BChris98/Advanced-PCB-Project/README.md

# Advanced-PCB-Project
Creating a PCB project for a led driver and an arduino
