BChris98/Advanced-PCB-Project/Pre-Rapport.docx

# Pré-Rapport : Advanced PCB Design

## Introduction :

Notre projet consiste à créer un shield Arduino comprenant :

- Une source de tension d’entrée comprise entre 19-24V
- Une alimentation stabilisée pour l’Arduino Uno
- Un circuit de contrôle de charge d’une batterie de 12V
- Une alimentation 35V pour les LED
- Une alimentation +/- 9V pour les Aop
- Une consigne pour le driver LED
- Driver LED (Bureau d’étude Electronique de puissance)

Pour cela, nous utiliserons différents ICs détaillés ci-dessous.

Schéma Bloc :

Voici le schéma bloc que nous avons décidé de créer pour le shield :

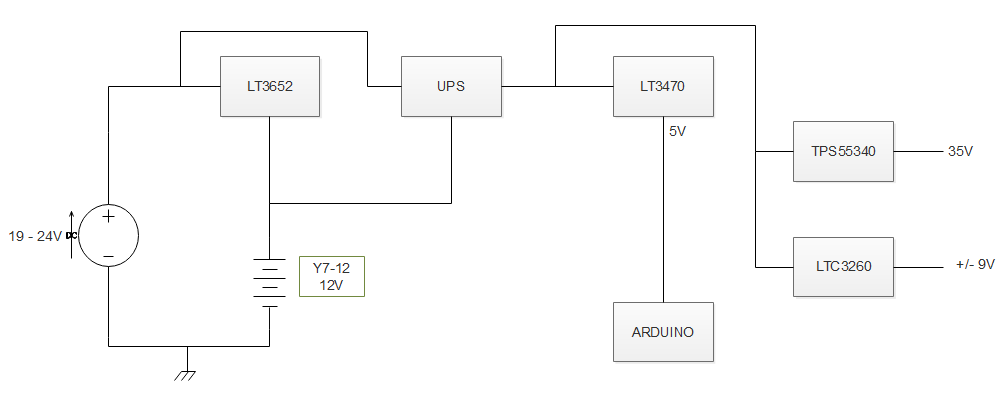
[picture p1: figure]

## LT3470 :

Le LT3470 est un buck converter capable de rabaisser une tension donnée, de 1.25V à 16V et de fournir un courant maximum de 200mA.

Il ne servira qu’à alimenter notre Arduino, donc nous n’avons pas besoin d’un buck converter capable de délivrer une grosse puissance.

Voici le schéma de ce buck converter :

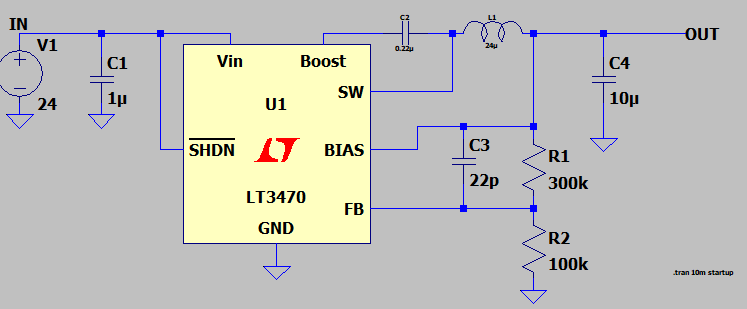
[picture p2: figure]

Nous allons maintenant décrire toute les entrées de l’IC, ainsi que chaque composant externe à cet IC.

Entrées :

- SHDN : C’est la pin utilisée pour shutdown l’IC. Si on n’utilise pas cet option, il faut relier la pin à V_(IN) .
- NC : Non-Connected pin.
- V_(IN) : Pin d’entrée de l’IC.
- GND : Ground de l’IC.
- SW: C’est l’output du switch interne.
- BOOST: Cette pin est utilisée pour booster via le NPN interne.
- BIAS: Cette pin est connectée à la diode Schottky interne ainsi qu’au régulateur interne. Si V_(OUT) >2V , il faut la connecter à V_(OUT) , sinon à V_(IN) .
- FB: C’est la feedback pin du régulateur interne.

Composants :

- Capacité V_(IN)

Une capacité d’entrée est conseillée pour la stabilité. Une entre 1µF à 2.2µF satisfait cette requête. Nous choisissons donc une de 1µF.

- Inductance :

L’inductance se calcule via cette formule donnée :

L_(MIN) = (V_(IN(MAX)) *t_(ON-TIME(MIN)))/(I_(MAX))

Où :

    - V_(IN(MAX)) =24V
    - t_(ON-TIME(MIN)) =150ns
    - I_(MAX) =150mA

L_(MIN) =2,4*10^(-5) H=24µH

- Feedback :

Le feedback est calculé par un diviseur résistif. Ces résistances sont calculées via cette équation :

V_(OUT) = 1.25V*(1 +(R1)/(R2))

(R1)/(R2)=3

Suivant la série E12 des résistances, nous trouvons :

  - R1 = 300k Ω
  - R2 = 100k Ω
- BOOST Pin :

La capacité et la diode Schottky interne sont utilisées pour générer un boost. Dans la plupart des cas, une capacité de 0.22µF suffira.

- Capacité BIAS :

Le ripple de sortie peut être réduit par l’ajout de capacité de découplage de 22pF entre BIAS et le FB.

- Capacité V_(OUT) :

La capacité de sortie filtre les ondulations non voulues du courant de l’inductance. Pour garder ces ondulations faibles, il nous faut une capacité de :

C_(OUT) > 50*L*((I_(LIM))/(V_(OUT)))^2

Où :

    - L = 0.24µF
    - I_(LIM) = 325mA
    - V_(OUT) =5V

C_(OUT) >5,88µF

Nous pouvons donc prendre une capacité de 10µF.

Simulation :

Voici donc ce que donne la simulation avec nos valeurs :

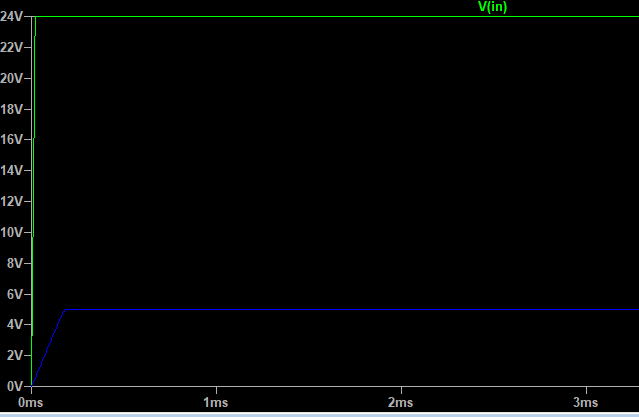
[picture p3: figure]

Nous pouvons voir que pour une entrée de 24V, nous avons bien une sortie de 5V.

## Uninterruptible Power Supply (UPS):

### LT3652 :

Cet IC permet de gérer la charge de la batterie au plomb, délivrant le courant de charge nominal de 1.7A à la tension de 13V, et gérant de façon appropriée le début et la fin de charge de batterie au plomb.

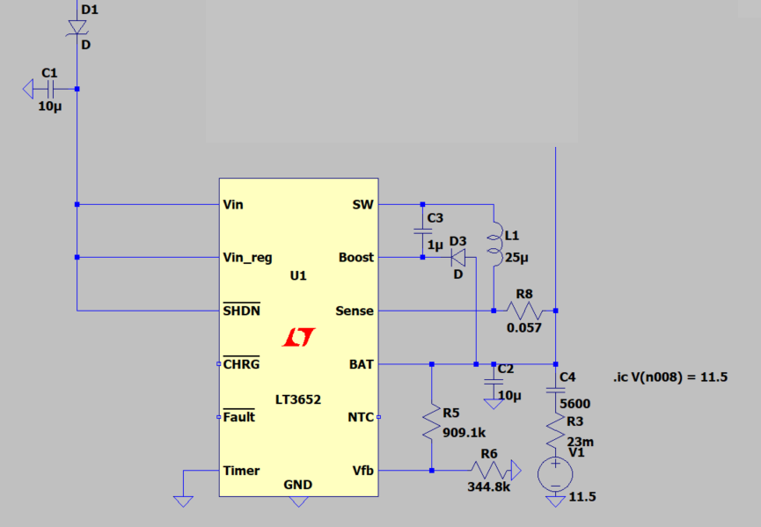
[picture p4: figure]

Le choix de l’IC s’est fait sur base des caractéristiques de charge de la batterie (tension de charge, courant de charge, type de batterie) ; la décision finale de sélectionner le LT3652 a été influencée par l’existence d’un modèle LTSpice du chargeur, rendant la simulation plus facile.

L’ensemble C4 R3 V1 est une modélisation du comportement de la batterie au plomb. R3 représente la résistance interne de la batterie, V1 représente la valeur de tension à vide (charge à 0%) de la batterie, et C4 est calculé à partir de la valeur de la capacité de la batterie, selon l’équation :

C=(Q*3600)/(∆V) [F]

Où ΔV est la différence entre la tension à 0% et celle à 100% de charge, et Q la charge (en Ah) de la batterie. [^1] Ce modèle a probablement une précision et un réalisme limité, mais suffit dans le cadre de notre simulation.

Le reste des composants sur ce schéma sont les composants de réglages du chargeur, dimensionnés selon les recommandations de la datasheet, comme décrit plus bas. Remarquons les condensateurs C1 et C2 qui servent de capacité de découplage.

Pins layout

- V_(IN) : Pin d’entrée/d’alimentation de l’IC (entre 4.95 et 32 V, et minimum 3.3V de plus que la tension de charge de la batterie => 15.3 V).
- V_(IN_REG) : Pin de régulation du courant de charge en fonction de la tension d’entrée. Puisque cette fonctionnalité n’est pas utilisée, la pin est connectée à Vin.
- SHDN : Désactive toutes les fonctions de charge si ShutDown est activé. Cette fonction n’est pas utilisée, la pin doit donc être connectée à Vin.
- CHRG : Indique le status de la sortie du chargeur ( CHRG est à 0 si la charge est en cours (le courant de charge est > Imax/10)). Cette pin peut être laissée flottante.
- FAULT : Indique les conditions de fautes durant un cycle de charge de la batterie. Cette pin peut également être laissée flottante.
- Timer : Pin de programmation de durée de charge, utilisée si on souhaite programmer une fin de charge après un certain délais (de plus, une faute apparait sur la pin précédente si la fin de charge n’est pas atteinte à la fin de ce délais). Cette fonction n’est pas utilisée non plus, la pin doit donc être connectée à la masse.
- V_(FB) : FeedBack de tension de batterie. La fonction de charge du LT3652 cherche à atteindre une tension de 3.3V sur cette pin ; le diviseur résistif doit donc être dimensionné à cet effet (pour qu’une tension de batterie pleine corresponde à 3.3V sur la pin).
- NTC : Pin de contrôle de la température, à laquelle connecter une thermistance de 10kOhms (à placer dans la batterie). Cette pin peut être laissée flottante.
- BAT : Pin de sortie du chargeur (sur laquelle il faut placer une capacité de découplage de 10µF). Lorsque le cycle de charge est terminé, cette pin délivre un courant < 1µA pour minimiser la décharge de la batterie.
- SENSE : Pin de détection de courant de charge, également utilisée pour fixer le courant de charge maximum.
- BOOST : Rail d’alimentation des interrupteurs, monté en bootstrap (avec un condensateur 1µF).
- SW : Pin d’output de l’interrupteur de sortie, qui court-circuite SW avec la pin Vin. Cette pin est bootstrappé à la pin BOOST.
- GND : Masse de l’IC.

Dimensionnement

Dimensionnons le pont résistif sur la pin V_(fb) . Les équations suivantes sont fournies dans la datasheet :

R1= (V_(BAT) (flt).2,5.10^5)/(3,3)

R2=(R1.2,5.10^5)/(R1-(2,5.10^5 ))

En sachant que V_(bat) (flt) = 13.65 V, on a R1 = 1034090.090 et R2 = 329710.527, avec un rapport R1/R2 de 3.1363 (d’autres résistances avec ce rapport et de l’ordre de grandeur des 100k peuvent être utilisées). Les valeurs de résistance présentes dans la simulation sont celles permettant d’obtenir une tension V_(bat) (flt) de 12V, qui est la tension nominale de la batterie et non sa tension de charge.

La tension sur la résistance placée sur la pin SENSE permet de régler le courant de charge moyen. Une tension de 100 mV correspond au courant de charge maximal (qui doit être <2A). L’équation permettant de trouver la valeur de résistance est donc simplement :

R_(SENSE) =0.1/(I_(CHG(MAX))) [Ω]=(0.1 V)/(1.75 A)=0.057Ω

La valeur d’inductance permet de régler l’amplitude d’oscillation du courant de charge. La datasheet recommande une amplitude relative d’oscillation (amplitude d’oscillation/offset DC = Ichg(max)) comprise entre 25 et 35%. La formule fournie permettant de trouver la valeur d’inductance est :

L=10*(R_(SENSE))/((ΔI_L)/(I_(CHG(MAX))))*V_(BAT(FLT)) *[1-(V_(BAT(FLT)))/(V_(IN(MAX)))](µH)

Ce qui donne, pour une amplitude relative d’oscillation de 25% et un Vin(max) de 24V, une valeur d’inductance de 13.42 µH. Il a cependant été observé à la simulation qu’avec une telle valeur d’inductance, l’amplitude relative était supérieure à 35% ; nous avons donc choisi une inductance de 25 µH, avec laquelle nous obtenons une amplitude de 18%.

Il est également spécifié dans la datasheet que l’inductance doit avoir un courant de saturation supérieur ou égale au courant maximum présent (en peak) dans l’inductance, soit supérieur à 2A.

### Changement de source :

Le circuit de charge a été simulé en même temps que celui de changement de source de tension, permettant la fonction d’UPS, dont voici le schéma :

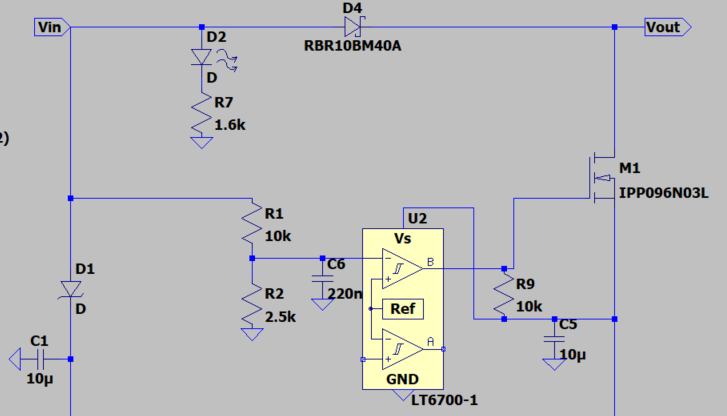
[picture p5: figure]

Le transistor NMOS M1 (à droite sur le schéma) permet de faire basculer la sortie V_(out) sur la batterie (voir schéma global ci-dessous). Sa grille est commandée par un comparateur, qui compare une référence de 400 mV avec la valeur de tension d’entrée divisée par 4.

Il en découle que si V_(in) tombe en dessous de 1.6V, la sortie du comparateur passe à l’état haut au travers de la résistance de pull-up R9, et M1 est passant ; si V_(in) est au-dessus de 1.6V, la sortie du comparateur est à l’état bas (la sortie du comparateur est en open-collector), et M1 est bloqué.

La diode D4 permet d’éviter que la batterie n’alimente le circuit de charge et l’entrée du comparateur (ce qui rebloquerait le transistor M1).

La led D2 servira de repère visuel rapide indiquant la présence d’une alimentation externe.

Les condensateurs C5 et C6 servent également de capacité de découplage.

Dimensionnement

Le transistor M1 a été choisi pour sa faible valeur R_(ds_(on)) , permettant de minimiser les pertes, ainsi que pour son grand courant de drain maximum et sa tension de seuil appropriée.

La diode D4 a été choisie pour son grand courant direct maximum (10A) et sa faible chute de tension directe (0.6V), permettant de plus faible pertes ; ainsi que sa bonne dissipation thermique ; une autre diode respectant ces critères serait tout aussi adaptée (le footprint utilisé n’est pas celui du modèle de diode de la simulation).

La résistance R7 permet de limiter le courant circulant dans la led. Pour une led montée en surface typique, un courant de 25 mA est nécessaire avec une chute de tension de 3V. Ceci veut dire que la résistance doit provoquer une chute de tension de 24-3 = 21V, avec un courant de 25 mA :

21V=R*0.025A=>R=840 Ω

Le pont diviseur en entrée du comparateur a été dimensionné pour avoir un rapport de division de 4, permettant une ouverture plus réactive du transistor M1 (l’entrée du comparateur peut aller jusqu’à 36V, cette valeur n’était donc pas limitante). Ainsi, le transistor M1 s’ouvrira après que la tension d’entrée soit passée sous les 1.6V et non les 400 mV.

### Schéma global

Ceci donne comme schéma global :

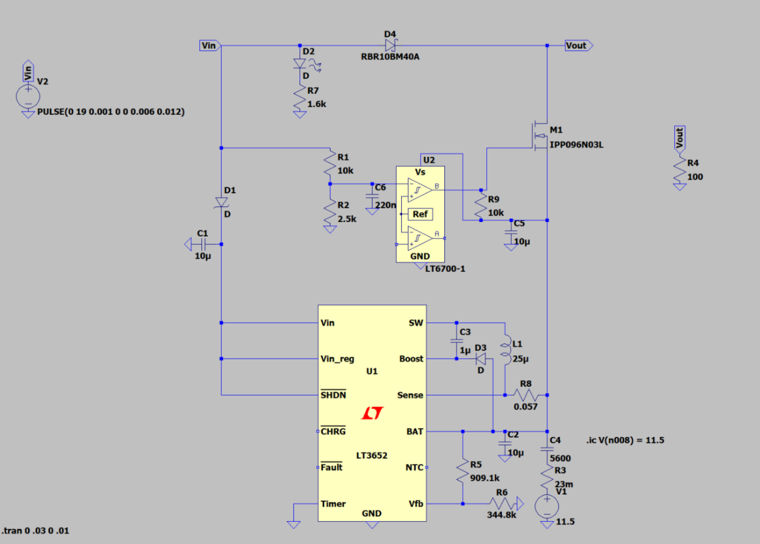
[picture p6: figure]

R4 symbolise une charge placée en aval du circuit.

Simulation

La simulation est réalisée en analyse transitoire, sur une durée de 30 ms. Durant cette période, nous simulons successivement la connexion et déconnexion d’une source de tension externe de 19V, ce qui nous permet d’observer le bon fonctionnement de la fonction « UPS » en même temps que celui de la fonction de charge de la batterie.

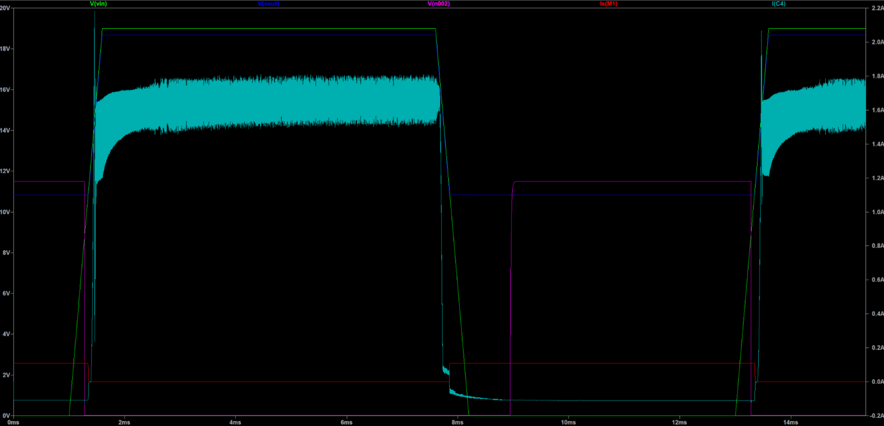
[picture p7: figure]

Tout d’abord, observons que la tension de sortie transitionne effectivement entre la tension de batterie et la tension Vin – 0.6V (chute due à D4), lorsque celle-ci est non nulle (quand on connecte une alimentation externe).

Ensuite, observons qu’un courant ne circule dans le transistor M1 que quand la tension Vin est sous un certain seuil (normalement 1.6V, mais le seuil semble ici se trouver à environ 12V => quand Vds vaut environ 0V). De plus, ce courant vaut bien 12V/100Ohms = 120 mA, comme attendu (diminuer la valeur de résistance de la charge fait augmenter le courant comme attendu également).

Enfin, observons que le courant dans la batterie (IC4, en bleu clair) devient négatif (à hauteur de -Is) lorsque M1 est passant ; ceci finit de démontrer que l’UPS fonctionne comme attendu. Le transistor est passant, la batterie se décharge et la tension de sortie = la tension de batterie, lorsque l’on retire l’alimentation externe. De plus, la transition se fait à une vitesse satisfaisante (de l’ordre de 0.1 ms).

En ce qui concerne la charge de la batterie (qui a lieu quand la source externe est connectée), le courant moyen varie entre 1.65 et 1.7 A, selon l’instant de la simulation sur lequel on zoome. Les pointes de courant montent quant à elles jusqu’à 1.8 A. Nous sommes donc suffisamment proche des 1.75 A désirés.

L’amplitude de l’oscillation est en moyenne de 1.8-1.48 = 0.32 A, soit 0.32 / 1.75 = 18.2 % de la valeur de courant désiré. Cette amplitude est donc légèrement inférieure aux 25% mentionnés plus tôt, ce qui semble cohérent puisque la valeur d’inductance utilisée pour la simulation est plus grande que la valeur calculée ; avec la valeur d’inductance de 13.42 µH déterminée précédemment, l’amplitude relative était de 41 %.

Enfin, nous avons constaté la présence d’un pic de courant au début de la charge de la batterie, atteignant les 2.2 A. Ce pic de courant est probablement dû au comportement capacitif de la batterie et ne portera pas à conséquence. Le pic est suivi d’une ondulation, jusqu’à ce que le circuit intégré stabilise le courant de charge moyen (ce qui se produit en 0.16 ms).

En conclusion, la fonction UPS et la charge de la batterie se déroule sans problème, dans notre simulation.

## Boost converter :

Afin que le driver de LED puisse délivrer un courant suffisant dans plusieurs LED branches en série, celui-ci doit être alimenté par une tension relativement grande. C’est à cela que sert le boost en convertissant la tension de l’alimentation 19-24V ou de la batterie 12V en une tension de 35V.

N.B : Malheureusement, la datasheet du circuit intégré choisie étant très pauvre en information, nous avons été amenés à nous documenter sur deux PDF de la marque Texas Instrument afin de dimensionner le circuit.

### Choix de l’IC :

Sachant que notre boost est alimenté par une tension comprise entre 12 et 24V et qu’il doit délivrer une tension de 35V avec un courant maximal de 1A, nous avons toutes les informations nécessaires pour trouver le circuit intégré qui répond aux exigences du projet.

Afin de pouvoir facilement réaliser une simulation sur LTSpice, nous nous sommes tournés vers un IC de la marque Linear Technology. Nous nous sommes alors rapidement tourné vers le LT1171 pour sa large gamme de tension d’entrée 3-60V et son courant de 2,5A.

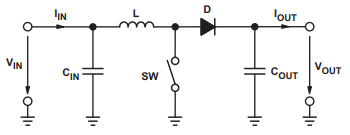
[picture p8: figure]

Mais après la lecture de la datasheet nous nous sommes aperçus que ce courant de 2,5A n’est pas appelé Iout (MAX) mais ILIM, ou “maximum switch current”. On parle donc en fait du courant qui passe par le transistor qui court-circuite l’inductance.

Il nout faut donc calculer nous même le courant de sortie maximal que ce circuit intégré peut délivrer, dans les conditions de notre application.
Ce calcul se fait en plusieurs étapes :

1) Duty-cycle D :

La tension minimale en entrée est utilisée car c’est celle-ci qui provoquera le plus grand courant dans le switch pour augmenter la tension jusque VOUT. Il faut bien sûr prendre en compte le rendement puisque celui-ci est étroitement lié au courant consommé lorsqu’on court-circuite l’inductance au travers du switch. Prendre un rendement minimum de 80% semble effectivement réaliste pour un boost converter.

D= 1- (12*0.8)/35 = 0.725

2) Inductor ripple current

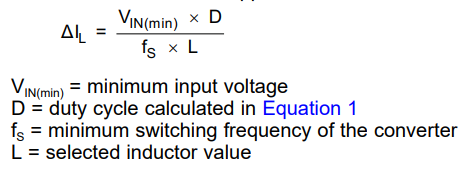
[picture p9: figure]

Le courant d’ondulation de la self varie en fonction de son inductance, mais aussi du duty-cycle et de la fréquence de signal.
La valeur de l’inductance pour faire un boost converter avec le LT117X est donnée par la datasheet et vaut 50uH. Mais selon les articles proposés par RS Components nous avons plutôt opté pour une inductance de 47uH.

ΔIL= (12 * 0,725)/(88*10^3 *47*10^-6) = 1,98 A

3) Maximum output current

ILIM(min) du LT1171 est donné dans la datasheet pour des duty-cycle de 50 et 80%. Afin d’obtenir un résultat le plus correct possible, on peut le calculer pour notre duty-cycle de 72,5% avec la formule ILIM=1,62 * (2 – D). Ce qui donne 2,06A.

IMAX OUT = (2,06- (1,98)/2)*(1-0,725) = 0,294A

On voit tout de suite qu’on est loin du courant maximal de 1A attendu. Il faut donc recommencer le calcul en prenant comme ILIM(min) celui du LT1170 :

ILIM=3,33 * (2 – D)= 4,245 A

Ce qui donne un IMAX OUT de 0.895A. Ce résultat est bien plus proche de notre valeur attendue, mais devrait tout de même être supérieure à 1A. Pour cela nous pouvons augmenter la valeur de l’inductance afin de diminuer le ripple current. La datasheet ne renseignant pas de gamme d’inductance recommandée, déterminons la par la formule proposée dans le PDF de Texas Instrument :

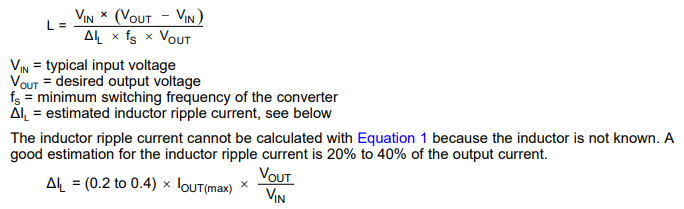
[picture p10: figure]

Ce qui nous donne, en utilisant les valeurs de ΔIL avec des facteurs de 0.2 et 0.4, et pour une Fs type de 100kHz, une gamme d’inductance entre 67 et 135uH.

Recalculons donc le ripple current et le maximum output current avec une inductance de 100uH :

ΔIL= (12 * 0,725)/(88*10^3 *100*10^-6) = 0,989 A

IMAX OUT = (4,245- (0,989)/2)*(1-0,725) = 1,031A

On obtient donc finalement, dans le pire des cas, un courant de sortie maximum suffisant.

On peut donc maintenant réutiliser cette dernière formule afin de calculer le véritable maximum switch current de notre application en ramplacant IMAX OUT par IOUT(max), soit le courant maximal de notre application :

Dans notre cas, on peut dire que IMAX OUT = IOUT(max). Ce qui fait que notre maximum switch current vaut en fait notre valeur minimal de limite du switch current ILIM(min), soit 4,245A.

Selon Texas Instrument, ce ISW(max) de 4,245A est le pic de courant que doivent pouvoir supporter le switch, mais aussi l’inductance et la diode externe.

### Choix de l’inductance :

La capacité de l’inductance a déjà été déterminée dans le choix du circuit intégré et vaut 100uH. Pour ce qui est de son courant, elle doit supporter des courants jusque ISW(max), soit 4,245A. Celui-ci étant en fait la somme du courant moyen dans la self plus la moitié de l’amplitude peak-to-peak du courant d’oscillation.

Nous avons donc opté pour une inductance de 100uH avec un Irms de 5,3A (SRP1770TA-101M).

### Choix de la diode :

Afin de réduire les partes au travers celle-ci, il est nécessaire d’utiliser une diode schottky pour leur faible chute de tension. Leur courant nominal doit être égal ou supérieur au courant de sortie maximum de notre convertisseur, soit 1A.

Les diodes schottky ayant des pics de courant nominaux très élevé, ceux de notre circuit ne poseront pas de problème.

Il faut cependant tout de même s’assurer que la diode peut dissiper sa chaleur :

La diode 1N5819 nous semble parfaitement correspondre au besoins de notre application grâce à son courant nominal IF=1A, sa tension directe VF=0.45V et sa dissipation de 0,45W sous 1A continu (illustrée ci-dessous).

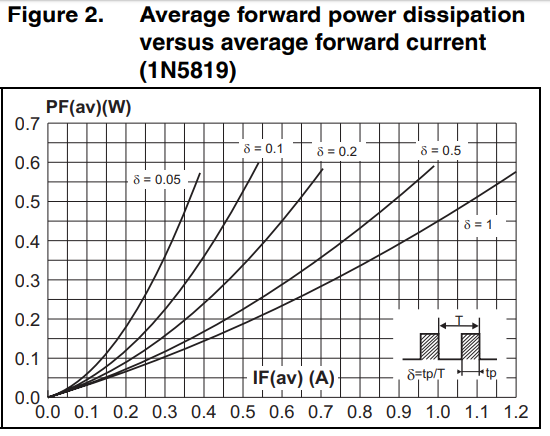
[picture p11: figure]

### Choix du pont diviseur :

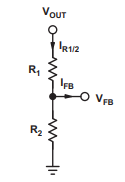
[picture p12: figure]

La tension de référence VFB et le courant de feedback sont donnés par la datasheet, et valent respectivement 1,244V et 350nA.

Il est conseillé par Texas Instrument d’avoir un courant IR1/2 au moins 100 fois plus grand que IFB, afin d’avoir au maximum 1% d’imprécision du la mesure de la tension VFB. Au-delà de 100 fois la précision continue d’augmenter, au dépit des pertes dans les résistances qui augmentent.

À partir de ces valeurs, on peut aisément calculer les valeurs de R1 et R2 comme suit :

Ce qui donne une une résitance R2 de 35,542 kOhm. Ayant pour cette valeur des pertes de l’ordre de 30uW à ses bornes, nous pouvons totalement choisir une résistance plus faible. Nous avons donc choisi une résistance classique de 10k à laquelle correspond une valeur théorique pour R1 de 271,35k. Une résistance de 270k ira donc très bien et fournira une tension de feedback de 1,245V avec la résistance de 10k.

### Choix du condensateur d’éntrée :

Texas Instrument nous conseille de respecter la valeur minimale de capacité en entrée indiquée dans la datasheet, ce afin de stabiliser la tension d’alimentation de l’IC malgré les pics de courant qu’il demande. Nous avons donc choisi d’utiliser le même condensateur que dans l’exemple d’application de la datasheet, soit un condensateur electrolytique de 100uF.

Cependant, il est aussi conseillé de choisir un condensateur céramique pour sa faible résistance série équivalente, ce qui lui permet de facilement fournir des hauts pics de courant. Nous hésitons donc à opter pour un condensateur céramique à la place d’un électrolytique…

### Choix du condensateur de sortie :

N’ayant toujours aucune indication dans la datasheet, nous utilisons la formule proposée par TI :

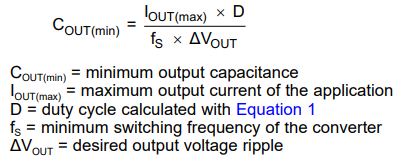
[picture p13: figure]

Cette formule permet de déterminer la capacité qu’il nous faut en fonction de l’oscillation souhaitée sur la tension de sortie. Nous avons choisi une capacité électrolytique de 270uF qui nous donnerait un oscillation de seulement 30mV. Mais la résistance équivalente de cette dernière ajoutant des oscillation, nous ajouterons un condensateur céramique de 100uF.

Une capacité totale de 370uF nous donne une oscillation de 22mV, sans prendre en compte les oscillations qui pourraient être ajoutées par les résistances des condensateurs.

### Simulation :

Schéma du circuit :

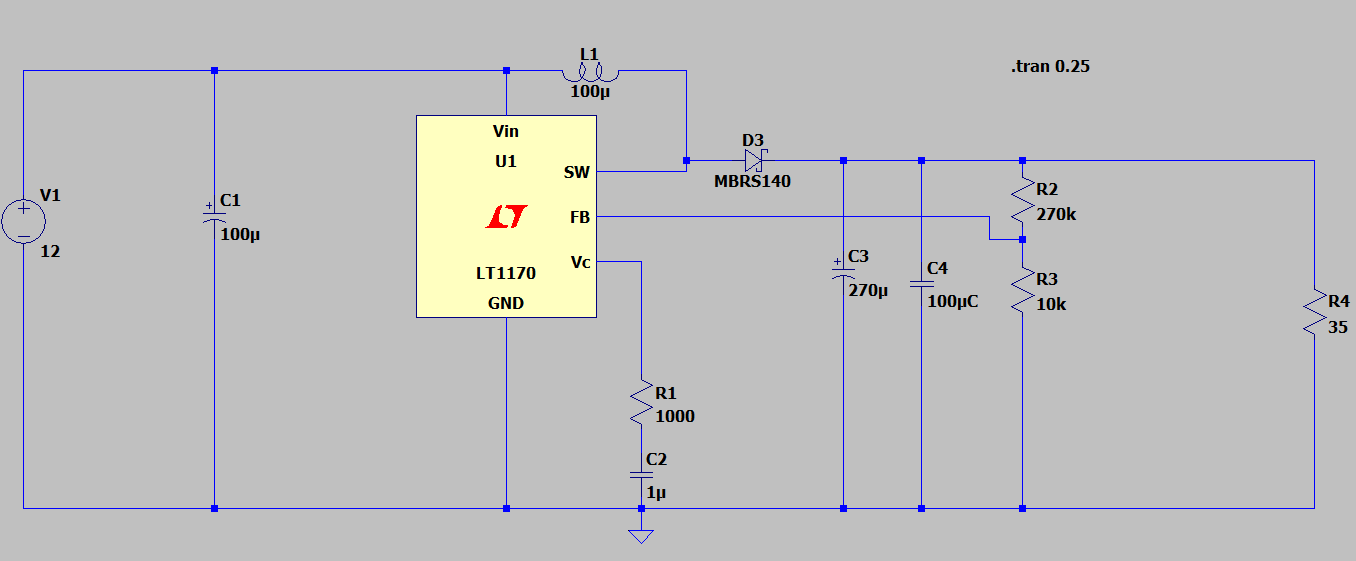
[picture p14: figure]
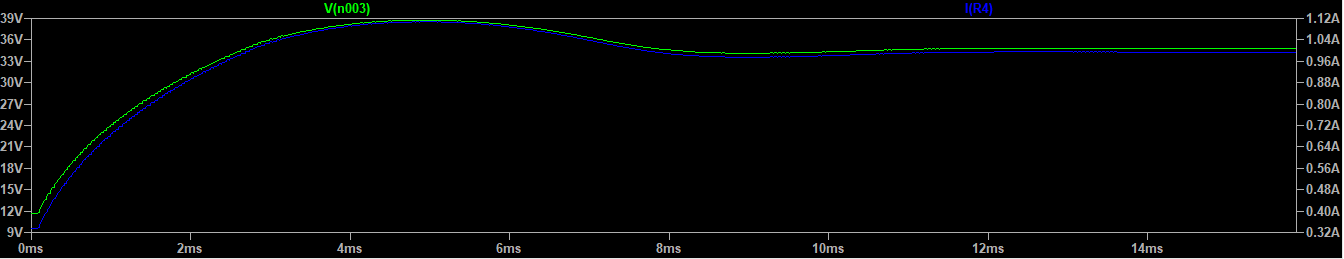
[picture p15: figure]

Sur cette simulation, on peut voir la tension et le courant dans la résistance de 35 Ohm qui grimpent puis se stabilisent après une dizaine de millisecondes à leurs valeurs attendues : 35V et 1A.

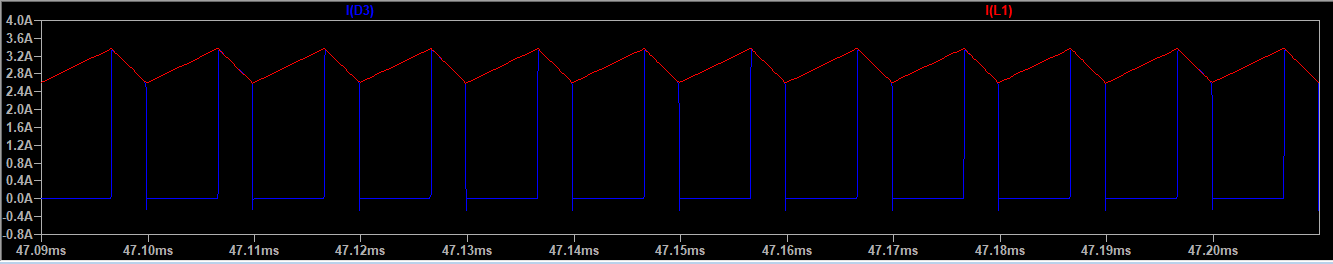
[picture p16: figure]

Ici, on peut visualiser que l’oscillation de courant sur la self correspond à celle précédemment estimée à 0,989A. Cependant, le courant moyen (IOUT/1-D) devrait etre de l’ordre de 3,57A, et pas 3,0A…
Pour la diode, qui conduit lorsque la self se décharge au travers elle, on peut voir qu’elle a effectivement un courant moyen d’environ 1A avec son signal presque rectangulaire de duty-cycle de 28% (1-D) montant jusque 3A.

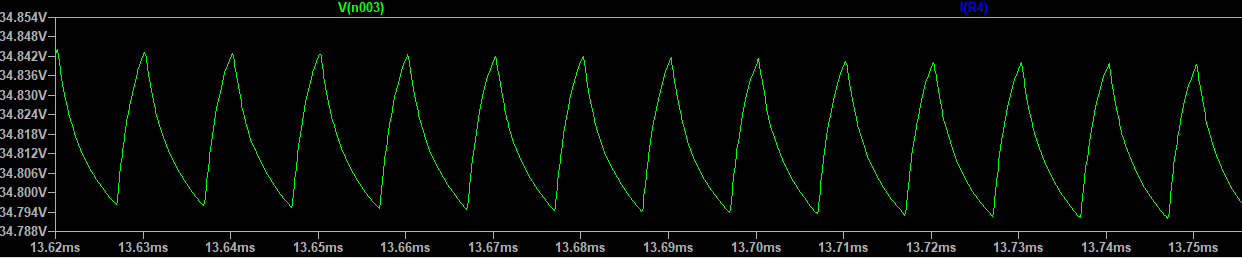
[picture p17: figure]

Cette mesure nous donne une ocillation d’environ 44mV sur la sortie, soit exactement 2 fois la valeur théorique. Pourtant la valeur calculée semble bien être l’amplitude peak-to-peak de l’oscillation…

### Conseils de layout :

Encore une fois, il nous a fallu nous tourner vers un PDF de Texas Instrument de trouver les conseils de layout pour bien concevoir un PCB de boost converter.

Dans l’ordre des priorités, le premier conseil est de placer le condensateur de sortie le plus près possible de la pin du circuit intégré. En effet, le courant étant en pulsations, il pourrait engendrer des pics de tension à cause de l’inductance parasite d’une longue piste. Et ces pics de tensions pouraient s’avérer destructeurs.

Si l’encombrement du gros condensateur de sortie ne permet pas de se mettre assez près, un petit condensateur peut être placé pour lisser la tension le plus près possible de la sortie de l’IC. Le plus gros peut alors être placé un peu plus loin.

Ensuite, l’inductance doit être elle aussi placée le plus près possible du circuit intégré. Mais cette fois, pour réduire au maximum les interférences électromagnétique.

Finalement, tout le reste des composants doivent eux aussi être placés le plus près possible afin de luter contre les inductances et capacités parasites des pistes.

## LTC3260 :

Cet IC permet de nous délivrer en sortie, du ± 9V qui nous permettra d’alimenter.

Voici le schéma qui nous permet cela :

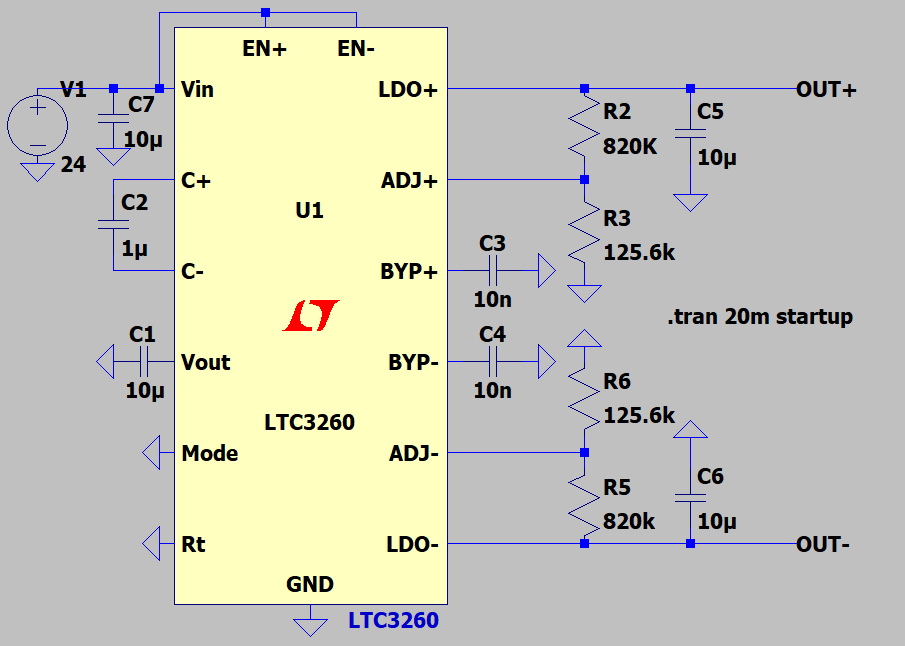
[picture p18: figure]

Nous allons maintenant décrire toute les entrée de l’IC et chaque composant externe à cet IC, ainsi que son utilité et sa valeur.

Entrées :

- V_(IN) : Pin d’entrée de l’IC. ( V_(IN) >|LDO| car V_(IN) est la saturation de l’Aop interne)
- EN⁺/EN⁻ : Active les sorties LDO⁺ et LDO⁻ en leurs envoyant un signal High.
- RT : Sert à programmer la fréquence de switch interne via une résistance. S’il n’y a pas de résistance, la fréquence est par défaut à 500kHz.
- BYP⁺/BYP⁻ : C’est la sortie bypass de LDO⁺ et LDO⁻. Mettre une capacité à cette borne permet de réduire le bruit sur les sorties LDO.
- ADJ⁺/ADJ⁻ : C’est le feedback du régulateur interne.
- MODE : Définit les mode de fréquence. Un High sur la pin définit un Burst Mode et un Low définit une fréquence constante.
- V_(OUT) : Si nous avons une fréquence constante, la sortie vaut - V_(IN) sinon, elle vaut –0,94*V_(IN) .
- C⁺/C⁻ : Capacité flottante pour la connexion positive/négative.
- NC : Non-Connected pin.
- GND : Ground.

Composants :

Remarque : les valeurs non calculées sont les valeurs conseillées par la datasheet.

- R_T :

Mettons cette pin à la masse pour avoir une fréquence maximal de 500kHz.

- Calcul des tensions de sorties via le feedback :

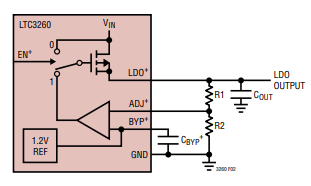
[picture p19: figure]

Le schéma du feedback est comme suit :

Nous avons simplement un Aop non inverser dont la sortie V_(out) de l’Aop est la sortie LDO (avec une entrée V_(in) de ± 1.2V ).

Pour calculer LDO, il nous suffit donc de nous référer à l’équation basique de V_(out) pour un non inverseur, soit :

±LDO= ±1,2.(1+(R2)/(R1))

Suivant la série E12 (dont nous disposons au laboratoire), nous prendrons comme valeur :

  - R1 = (120k Ω + 5,6 kΩ )
  - R2 = 820k Ω

Pour la stabilité, il est conseiller de mettre une petite capacité de découplage en céramique d’au moins 2µF (en fonction de la température et de la tension d’entrée) sur la sortie LDO.

V_(RIPPLE) (P-P)≈(I_(OUT))/(C_(OUT)).(1/(f_(OSC)) – t_(ON) )

Sachant que :

    - t_(ON) =1µs
    - I_(OUT) =50mA
    - C_(OUT) >2µF
    - f_(OSC) = 500kHz

V_(RIPPLE) (P-P)= (5*10^(-8))/(C_(OUT))

On souhaite avoir un ripple voltage le plus petit que possible pour que notre sortie soit la plus stable. C_(OUT) doit donc ne pas être trop petit.

Si nous prenons un C_(OUT) =10µF , on obtient un V_(RIPPLE) (P-P)=5mV ce qui est assez correcte pour notre utilisation.

Une capacité de 10nF peut être connectée sur les pin BYP pour éviter le bruit sur l’entrée de l’Aop et avoir donc un V_(IN) constant.

- Capacité V_(IN) /V_(OUT) :

Il est conseiller que ces capacités soit du même ordre de grandeur que celle à la sortie de LDO.

- Capacités flottantes:

Une capacité de découplage en céramique de 1µF ou plus grand est suggérer pour l’IC.

- Mode:

Il est conseiller d’utiliser le mode de fréquence constante, donc nous mettrons cette pin à la masse.

Simulation :

Voici donc ce que donne la simulation avec nos valeurs :

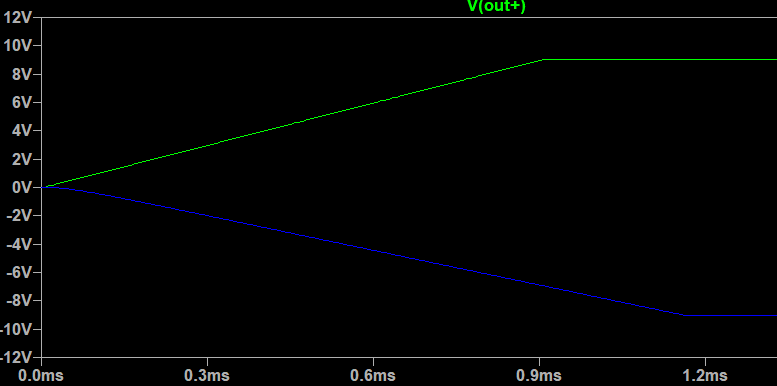
[picture p20: figure]

Après une transition de +/- 1.2ms, nous avons bien une tension +9V et une tension -9V

## PCB :

### LT3470 :

La boucle formée par le switch interne, la diode interne et la capacité d’entrée doit être la plus petite que possible.

Le ground du système doit être tiré sur le ground du régulateur en un seul endroit, cela prévient le bruit qu’il pourrait y avoir dans le switch.

La bobine et la capacité de sortie doivent être placé du même côté du PCB et leur connexions doivent être faite sur un même layer.

Additionnellement, SW et BOOST doivent rester les plus petits que possible. Ces pins peuvent induire du bruit dans le feedback à cause de l’induction et augmenter ainsi le ripple de sortie. Pour régler ce soucis, il faut utiliser un via pour relier Vout et le feedback diviseur.

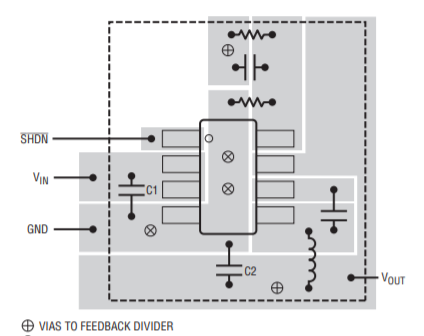
[picture p21: figure]

### LTC3260 :

Une grande surface de ground et de petite connexion aux capacités externes vont augmenter la performance.

La capacité flottantes entre C+ et C- ne doit pas être routé près de pin sensible comme les pins ADJ et les pins BYP.

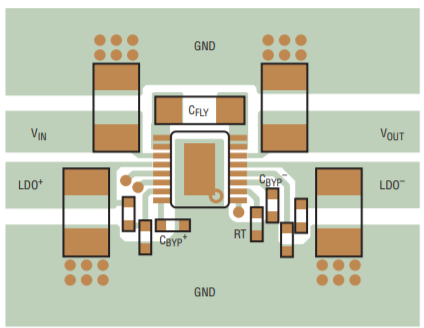
[picture p22: figure]

[^1] Cette modélisation a été trouvée sur https://www.eevblog.com/forum/projects/lead-acid-battery-ltspice-model/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

Bernard Tourneur Julien Gorjon Christos Bournousouzis
