BChris98/Advanced-PCB-Project/PCB/LT3652/Project Outputs for ArduinoUnoSheild/ArduinoUnoSheild.xls

Sheet: ArduinoUnoSheild
Comment / Value | Description | Designator | Footprint | LibRef | Quantity | Unit price | Pack | Nb of pack | Total price | Link | Real cost | Ref
10uF |  | C1, C2, C5, C9, C10, C13, C15, C16 | 0805 CAP | 1uF/0805 | 24 | 0.111 | 50 | 1 | 5.55 | https://befr.rs-online.com/web/p/mlccs-multilayer-ceramic-capacitors/1034147/ | 2.664 | 103-4147
1uF |  | C3, C6, C12, C19 | 0805 CAP | 1uF/0805 | 12 | 0.111 | 50 | 1 | 5.55 | https://befr.rs-online.com/web/p/mlccs-multilayer-ceramic-capacitors/1843918/ | 1.332 | 103-4147
0.22uF |  | C7 | 0805 CAP | 1uF/0805 | 6 | 0.039 | 50 | 1 | 1.95 | https://befr.rs-online.com/web/p/mlccs-multilayer-ceramic-capacitors/1034126/ | 0.234 | 103-4126
22pF |  | C8 | 0805 CAP | 1uF/0805 | 3 | 0.069 | 25 | 1 | 1.725 | https://befr.rs-online.com/web/p/mlccs-multilayer-ceramic-capacitors/2644258/ | 0.207 | 264-4258
100nF |  | C21 | 0805 CAP | 1uF/0805 | 3 | 0.133 | 10 | 1 | 1.33 | https://be.farnell.com/avx/06035c104jat2a/cap-0-1-f-50v-5-x7r-0603/dp/1740621?st=100nF | 0.399 | 1740621
10nF |  | C11, C14 | 0603 CAP | 1uF/0805 | 6 | 0.049 | 50 | 1 | 2.45 | https://befr.rs-online.com/web/p/mlccs-multilayer-ceramic-capacitors/4614013/ | 0.294 | 461-4013
Cond pol radial | Condensateur polatisé | C17 | CAPPR1.5-4x5 | Cond pol radial | 3 | 0.108 | 25 | 1 | 2.7 | https://befr.rs-online.com/web/p/aluminium-capacitors/7047992/ | 0.324 | 704-7992
Cond pol radial | Condensateur polatisé | C18 | CAPPR2-5x10 | Cond pol radial | 3 | 0.0534 | 10 | 1 | 0.534 | https://befr.rs-online.com/web/p/aluminium-capacitors/7152861/ | 0.1602 | 715-2861
 | Diode schottky | D5 | DIODE-0.4 |  | 3 | 0.062 | 5 | 1 | 0.31 | https://be.farnell.com/fr-BE/multicomp/1n4001/diode-simple-50v-1a-do-204al/dp/2675791?st=1N4001 | 0.186 | 2675791
Diode | Diode | D1, D3 | SMB | Diode | 6 | 0.183 | 5 | 2 | 1.83 | https://be.farnell.com/fr-BE/rohm/rb060l-40te25/diode-schottky-40v-2a-sod-106/dp/1680017RL?st=40TE25 | 1.098 | 1680017RL
Diode Zener | Diode | D4 | DIODE-0.4 | Diode | 3 | 0.392 | 1 | 3 | 1.176 | https://be.farnell.com/fr-BE/on-semiconductor/mur420g/diode-redress-puissance-uf/dp/1651054?st=MUR420G | 1.176 | 1651054
Fusible | Fusible 5A | F1 | Fuse_holder | Fusible | 3 | 0.13 | 10 | 1 | 1.3 | https://befr.rs-online.com/web/p/cartridge-fuses/0563532/ | 0.39 | 563-532
LT3652 |  | IC1 | MSOP12 - EP | LTC3652 | 2 | 6.42 | 1 | 2 | 12.84 | https://befr.rs-online.com/web/p/battery-charge-controller-ics/7618796/ | 12.84 | 761-8796
LTC3260EMSE#PBF | Integrated Circuit | IC2 | SOP50P490X110-17N | LTC3260EMSE#PBF | 2 | 7.19 | 1 | 2 | 14.38 | https://befr.rs-online.com/web/p/charge-pumps/8516768/ | 14.38 | 851-6768
LT1171CT | Integrated Circuit | IC3 | TO170P457X1022X2306-5P | LT1171CT#PBF | 2 | 9.77 | 1 | 2 | 19.54 | https://befr.rs-online.com/web/p/buck-boost-switching-regulators/5455001/ | 19.54 | 545-5001
Headers Arduino uno |  |  |  |  | 1 | 7.15 | 1 | 1 | 7.15 | https://www.amazon.fr/Arduino-Stackable-Header-Kit-R3/dp/B00Q6Y74DA?__mk_fr_FR=%C3%85M%C3%85%C5%BD%C3%95%C3%91 | 7.15
Connecteur 2 | Connecteur | J1 | Jack_connector | Connecteur 2 | 3 | 0.852 | 5 | 1 | 4.26 | https://befr.rs-online.com/web/p/dc-power-sockets/1224879/ | 2.556 | 122-4879
Connecteur 2 | Connecteur | J1 | Terminal block - 2 ways | Connecteur 2 | 3 | 0.027 | 10 | 1 | 0.27 | https://befr.rs-online.com/web/p/pcb-terminal-blocks/8970736/ | 0.081 | 897-0736
Driver LED | Connecteur | J3 | Connector 5 | Connecteur 5 | 3 | 0.0751 | 10 | 1 | 0.751 | https://befr.rs-online.com/web/p/pcb-terminal-blocks/8970819/ | 0.2253 | 897-0819
22µH | Inductance | L1 | INDPM7070X580N | Inductance | 6 | 0.93 | 5 | 2 | 9.3 | https://befr.rs-online.com/web/p/wire-wound-surface-mount-inductors/7701151/ | 5.58 | 770-1151
47µH | Inductance | L3 | Self100uH | Inductance | 3 | 2.56 | 1 | 3 | 7.68 | https://befr.rs-online.com/web/p/wire-wound-surface-mount-inductors/9054788/ | 7.68 | 905-4788
LED diode | LED | LD1 | LED_0603 | LED diode | 3 | 0.171 | 30 | 1 | 5.13 | https://befr.rs-online.com/web/p/leds/1826312/ | 0.513 | VAOL-S6SB4
green | LED green | LD2 | LED_0603 | LED diode | 3 | 0.047 | 5 | 1 | 0.235 | https://be.farnell.com/fr-BE/rohm/sml-d12p8wt86c/led-aec-q101-vert-6-3mcd-0603/dp/2687486?st=0603%20led | 0.141 | 2687486
IPP096N03L | MOSFET | M1 | TO-220 V | NMOS-IPP096 | 3 | 0.806 | 5 | 1 | 4.03 | https://befr.rs-online.com/web/p/mosfets/7545493/?searchHistory=%7B%22enabled%22%3Atrue%7D | 2.418 | 754-5493
Connecteur 3 |  | PIR Sensor | Connector 3 | Connecteur 3 | 3 | 0.041 | 10 | 1 | 0.41 | https://befr.rs-online.com/web/p/pcb-terminal-blocks/8970730/ | 0.123 | 897-0730
10k | Résistance standard | R1, R18, R19 | 0603 RES | Résistance | 9 | 0.00167 | 10 | 1 | 0.0167 | https://be.farnell.com/fr-BE/te-connectivity/crgcq0603j10k/res-aec-q200-couche-epaisse-10k/dp/2861870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 | 0.01503 | 2861870
2.5k | Résistance standard | R2 | 0603 RES | Résistance | 3 | 0.00454 | 10 | 1 | 0.0454 | https://be.farnell.com/fr-BE/murata/blm18bd252sn1d/perle-de-ferrite-0603-2-5k-ohms/dp/1515709?st=0603%202.5k | 0.01362 | 1515709
1.034M | Résistance standard | R5 | 0603 RES | Résistance | 3 | 0.00038 | 10 | 1 | 0.0038 | https://be.farnell.com/fr-BE/multicomp/mcwr06x1004ftl/res-couche-epaisse-1m-1-0-1w-0603/dp/2447285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 | 0.00114 | 2447285
329.7k | Résistance standard | R6 | 0603 RES | Résistance | 3 | 0.00038 | 10 | 1 | 0.0038 | https://be.farnell.com/fr-BE/multicomp/mcwr06x3303ftl/resistance-thick-film-330kohm/dp/2447338?st=0603%20330k | 0.00114 | 2447338
300k | Résistance standard | R9 | 0603 RES | Résistance | 3 | 0.00038 | 10 | 1 | 0.0038 | https://be.farnell.com/fr-BE/multicomp/mcwr06x3003ftl/resistance-thick-film-300kohm/dp/2447330?st=0603%20300k | 0.00114 | 2447330
100k | Résistance standard | R10 | 0603 RES | Résistance | 3 | 0.00037 | 10 | 1 | 0.0037 | https://be.farnell.com/fr-BE/multicomp/mcwr06x1003ftl/res-couche-epaisse-100k-1-0-1w/dp/2447226?st=0603%20100k | 0.00111 | 2447226
220 o | Résistance standard | R11 | 0603 RES | Résistance | 3 | 0.00038 | 10 | 1 | 0.0038 | https://be.farnell.com/fr-BE/multicomp/mcwr06x2200ftl/res-couche-epaisse-220r-1-0-1w/dp/2447298?st=0603%20220 | 0.00114 | 2447298
820k | Résistance standard | R12, R14 | 0603 RES | Résistance | 6 | 0.00038 | 10 | 1 | 0.0038 | https://be.farnell.com/fr-BE/multicomp/mcwr06x8203ftl/resistance-thick-film-820kohm/dp/2447436?st=0603%20820k | 0.00228 | 2447436
125.6k | Résistance standard | R13, R15 | 0603 RES | Résistance | 6 | 0.954 | 1 | 6 | 5.724 | https://be.farnell.com/fr-BE/holsworthy-te-connectivity/rq73c1j124kbtdf/res-124k-0-1-0-15w-0603-couche/dp/3229445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 | 5.724 | 3229445
1k | Résistance standard | R16 | 0603 RES | Résistance | 3 | 0.00037 | 10 | 1 | 0.0037 | https://be.farnell.com/fr-BE/multicomp/mcwr06x102-jtl/res-couche-epaisse-1k-5-0-1w-0603/dp/2694685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 | 0.00111 | 2694685
270k | Résistance standard | R17 | 0603 RES | Résistance | 3 | 0.00038 | 10 | 1 | 0.0038 | https://be.farnell.com/fr-BE/multicomp/mcwr06x2703ftl/resistance-thick-film-270kohm/dp/2447313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 | 0.00114 | 2447313
1.8k | Résistance standard | R7, R20 | 1206 RES | Résistance | 6 | 0.008 | 50 | 1 | 0.4 | https://befr.rs-online.com/web/p/surface-mount-fixed-resistors/2232293/ | 0.048 | 223-2293
57 m | Résistance standard | R8 | 1812 RES | Résistance | 3 | 0.686 | 5 | 1 | 3.43 | https://befr.rs-online.com/web/p/surface-mount-fixed-resistors/0566080/ | 2.058 | 566-080
LT6700HS6-1 | Analog Comparators LT6700 - Micropower, Low Voltage, Dual Comparator with 400mV Reference | U1 | *TSOT-23_S6 | LT6700HS6-1 | 2 | 2.195 | 2 | 1 | 4.39 | https://befr.rs-online.com/web/p/comparators/7869730/ | 4.39 | 786-9730
LT3470ITS8 | No Description Available | U2 | TSOT-23_TS8 | LT3470ITS8 | 2 | 6.19 | 1 | 2 | 12.38 | https://befr.rs-online.com/web/p/dc-dc-converters/7618709/ | 12.38 | 761-8709
 |  |  |  | Total : | 170 | 47.52173 |  |  | 138.7973 |  | 106.33035

Sheet: Compatibility Report
Compatibility Report for ArduinoUnoSheild.xls
Run on 13/11/2019 22:48
If the workbook is saved in an earlier file format or opened in an earlier version of Microsoft Excel, the listed features will not be available.
Minor loss of fidelity | # of occurrences | Version
Some cells or styles in this workbook contain formatting that is not supported by the selected file format. These formats will be converted to the closest format available. | 1 | Excel 97-2003
