BChris98/Advanced-PCB-Project/Simulations/LT3652/batCharger.asc

C1: cap; 10µ
C2: cap; 10µ
C3: cap; 1µ
C4: cap; 5600
C5: cap; 10µ
C6: cap; 220n
D1: zener
D2: LED
D3: diode
D4: schottky; RBR10BM40A
L1: ind; 25µ
M1: nmos; IPP096N03L
R1: res; 10k
R2: res; 2.5k
R3: res; 23m
R4: res; 5
R5: res; 1.034Meg
R6: res; 329.71k
R7: res; 840
R8: res; 0.057
R9: res; 10k
U1: LT3652
U2: LT6700-1
V1: voltage; 11.5
V2: voltage; PULSE(0 19 0.001 0 0 0.006 0.012)
Named nets: 0, Vin, Vout
.ic V(n008) = 11.5
.tran 0 .03 0 .01
