BChris98/Advanced-PCB-Project/Simulations/LT1171/Simu boost.asc

C1: polcap; 100µ; V=4 Irms=3.72678 Rser=0.018 Lser=0 mfg="KEMET" pn="A700D107M004ATE018" type="Al electrolytic"
C2: cap; 1µ
C3: cap; 1000µ
D3: schottky; MBRS340
L1: ind; 50µ
R1: res; 1000
R2: res; 27112
R3: res; 1000
R4: res; 35
U1: LT1171
V1: voltage; 14
Named nets: 0
.tran 0.25
