BChris98/Advanced-PCB-Project/Simulations/LTC3260/LTC3260_TA03.asc

C1: cap; 10µ
C2: cap; 1µ
C3: cap; 10n
C4: cap; 10n
C5: cap; 10µ
C6: cap; 10µ
C7: cap; 10µ
R2: res; 820K
R3: res; 125.6k
R5: res; 820k
R6: res; 125.6k
U1: LTC3260
V1: voltage; 24
Named nets: 0, OUT+, OUT-
.tran 20m startup
LTC3260
