BChris98/Advanced-PCB-Project/Simulations/LT3470/LT3470.asc

C1: cap; 1µ
C2: cap; 0.22µ
C3: cap; 22p
C4: cap; 10µ; Rser=.025
L1: ind; 24µ; Rser=.1
R1: res; 300k
R2: res; 100k
U1: LT3470
V1: VOLTAGE; 24
Named nets: 0, OUT, IN
.tran 10m startup
