BChris98/Advanced-PCB-Project/(list of files, drawings)

Other design files:
PCB/LT3470/LT3470.PrjPCB
PCB/LT3470/LT3470.SchDoc
PCB/LT3652/ArduinoUnoSheild.PrjPcb
PCB/LT3652/ArduinoUnoShield.PcbDoc
PCB/LT3652/ArduinoUnoShield.SchDoc
PCB/LT3652/charger_LT3652.PcbLib
PCB/LT3652/charger_LT3652.SchLib
PCB/LT3652/Header.PcbLib
PCB/LT3652/Header.SchLib
PCB/LT3652/LT1171.SchDoc
PCB/LT3652/LT3470.SchDoc
PCB/LT3652/LTC3260.SchDoc
PCB/LT3652/ups.SchDoc
PCB/LTC3260/LTC3260.PrjPCB
PCB/LTC3260/LTC3260.SchDoc
