BChris98/Advanced-PCB-Project/(commit log)

2019-11-05 add board shape - first component
    [ArduinoUnoSheild.PrjPcb, ArduinoUnoShield.PcbDoc, ArduinoUnoShield.SchDoc, Header.PcbLib, Header.SchLib, charger_LT3652.PcbLib, charger_LT3652.SchLib]
2019-11-05 Adding PCB comments
2019-11-05 Adding LT3470 schematic and library
    [LT3470.PrjPCB, LT3470.SchDoc]
2019-11-05 Adding LTC3260 schematic and library
    [LTC3260.PrjPCB, LTC3260.SchDoc]
2019-11-05 Changinc CAD file place
    [ArduinoUnoSheild.PrjPcb, ArduinoUnoShield.PcbDoc, ArduinoUnoShield.SchDoc, Header.PcbLib, Header.SchLib, charger_LT3652.PcbLib, charger_LT3652.SchLib]
2019-11-06 Boost simulation + library and schematic
2019-11-06 add LT3652 ups and buck converter to pcb
    [ArduinoUnoSheild.PrjPcb, ArduinoUnoShield.PcbDoc, ArduinoUnoShield.SchDoc, Header.PcbLib, Header.SchLib, LT3470.SchDoc, LTC3260.SchDoc, charger_LT3652.PcbLib]
2019-11-06 include LTC schematics
    [ArduinoUnoShield.SchDoc, LTC3260.SchDoc, charger_LT3652.PcbLib, charger_LT3652.SchLib]
2019-11-10 include boost and symetric alim on pcb
    [ArduinoUnoShield.PcbDoc, ArduinoUnoShield.SchDoc, LT1171.SchDoc, LT3470.SchDoc, LTC3260.SchDoc, charger_LT3652.PcbLib, charger_LT3652.SchLib]
2019-11-11 finalize pcb
    [ArduinoUnoSheild.PrjPcb, ArduinoUnoShield.PcbDoc, ArduinoUnoShield.SchDoc, charger_LT3652.PcbLib, charger_LT3652.SchLib]
2019-11-12 Made footprint for new inductor
2019-11-12 small changes in PCB and complete report about lt3652
    [ArduinoUnoShield.PcbDoc, ArduinoUnoShield.SchDoc, ups.SchDoc]
2019-11-13 edit boost footprint and positions, and resistors footprint
    [ArduinoUnoSheild.PrjPcb, ArduinoUnoShield.PcbDoc, ArduinoUnoShield.SchDoc, LT1171.SchDoc, LT3470.SchDoc, charger_LT3652.PcbLib, charger_LT3652.SchLib, ups.SchDoc]
2019-11-13 include bom and few modif on report
    [ArduinoUnoSheild.xls, ArduinoUnoShield.PcbDoc, ups.SchDoc]
2019-11-13 edit word and add datasheet
    [ArduinoUnoSheild.PrjPcb]
2019-11-14 edit bom with prices
    [ArduinoUnoSheild.xls]
2019-11-22 add measurement access points and capacitor for boost
    [ArduinoUnoShield.PcbDoc, LT1171.SchDoc, ups.SchDoc]
2019-11-26 add measurement of vout and edit C17 footprint
    [ArduinoUnoShield.PcbDoc, LT1171.SchDoc, charger_LT3652.PcbLib, charger_LT3652.SchLib]
2019-11-26 edit BOM
    [ArduinoUnoSheild.xls, ups.SchDoc]
2019-11-28 Updated References
    [ArduinoUnoSheild.xls]
2019-11-29 edit BOM and few changes on PCB
    [ArduinoUnoSheild.xls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]
